rsx-electrical/rsx_standard_library/(commit log)

2025-02-01 add STM32F767ZI symbol
2025-02-01 STM32F767ZI with DPN, MPN and MFR
2025-02-01 Adding Resistor Values: 1.8K, 7.5K, 9.1K, 8.2K
2025-02-01 added 39K resistor
2025-02-01 added 75K resistor
2025-02-08 Added 7.5k resistor
2025-02-08 re-added 10k resistor after it deleted
2025-02-08 added 8.2k resistor
2025-02-08 added 24k resistor
2025-02-08 added 9.1k resistor
2025-02-08 added 1.8k resistor
2025-03-01 update cap, diode, fuse
2025-03-01 added sensors
2025-03-01 75 OHM RESISTOR
2025-03-01 Added Temperature Sensor
2025-03-02 added bms adaptor
2025-03-08 bms additions
2025-03-09 BMS change?
2025-03-15 added footprint
2025-03-22 footprint hall effect
2025-03-22 hall sensor footprint
2025-03-22 buzzer footprint
2025-03-22 button footprint
2025-03-22 button symbol
2025-03-23 add 1k5 resistor
2025-04-26 science board additions
2025-06-21 added new wurth connector (64901229522), schematic + footprint
2025-07-15 added 5V relay
2025-08-14 added all the symbol/footprints/3dModels for the sensor board
2025-08-17 more resistor
2025-10-02 add Jason's current sensor and voltage regulators
2025-10-04 add 0.47 resistor
2025-10-04 add SS2040 diode
2025-10-13 add 12V_iso_reg_TBA21222, wago connector, 4x1 screw terminal, m6 mountinghole
2025-10-15 91K, 82K, PDB MOSFETS, 10K added
2025-10-15 30A diode
2025-10-18 MCH3478 SOT-23 N-Channel 30V/2A
    Transistor
2025-10-18 Arduino Nano Every
2025-10-18 15V power supply added
2025-10-18 addbattery connector
2025-10-18 add push button
2025-10-20 Added Battery Display Components
    Added Components:
    FPC Connector
    Capacitors
    Diodes
    NMOS
2025-10-24 add 15V Voltage reg for PDP
2025-10-25 new 15V voltage reg and transistor datasheet
2025-11-01 Add Wago_2716-101 and Wurth_64900429522 connectors
2025-11-06 fix 3 pos screw terminal for PDP
2025-11-30 add 2pin wurth connector for pdp
2025-12-05 add wurth 64900221122 connector
2026-01-17 added 300k resistor, 100nC capacitor, OPA992IDBVR opamp
2026-01-17 reduced the solder mask expansion of connector pins
2026-01-24 Fixed link between symbol and footprint of OPA2186DR op amp
2026-03-14 add bms controoler
2026-03-17 added footprints for 2pin JST and an UV LED
2026-03-17 Added footprints and symbols for Blue LED and 3pin JST connector
2026-03-17 added updated 2 pin JST connector symbol and footprint
2026-03-17 final updated version of 2 and 3 pin JST connectors footprints and symbols
2026-03-17 moved the UV LED to LED folder from diodes folder
2026-03-17 Added footprint for science CAN capacitor, modified science blue LED pin properties, and reverted changes to the BSS308 diode
2026-03-19 Added capcitor (RDE5C2A220J0M1H03A) symbol to symbols folder (footprint is already there)
2026-03-22 new components for sensor board
2026-03-28 add 47u electrolytic cap5V buck
2026-03-28 resistor reset
2026-03-28 Added 5V buck components (Anthony's board)
2026-05-01 added the 7pin through hole connector symbol and footprint and changed the symbol name for the TJA1050 component
2026-05-05 3.5pitch 2 pin screw terminal
2026-05-08 Making further changes to some Science LEDs and connectors
2026-05-08 Added new capacitor symbol and properties (RDE5C2A220J0M1H03A).
2026-05-21 Added numerous capacitors, resistors and transistors
2026-06-02 added new capacitors
    2.2u
    27p
    33p
    390p
2026-08-13 Added PBQ41Z90PVPT BMS chip used for sensing, fuel guaging and protection
2026-08-13 Added Components for BMS cell balancing external circuit
    Additions:
    18R_2W
    22R
    50R
    T2N7002BK,LM
2026-08-19 Added resistors and new nmos
    40.2R
    56R
    AO3414
2026-08-22 Added shunt resistor and thermistor for BMS
2026-10-11 Added IC DIP Socket 2x4
    - used in programmer board (ATTiny)
    - misc
    - https://www.digikey.ca/en/products/detail/te-connectivity-amp-connectors/1-2199298-2/5022039
2026-10-12 Added IC DIP Socket 2x19 + Fixes
    - used in programmer board (ATMega)
    - Added IC DIP Socket 2x4 information
    - https://www.digikey.ca/en/products/detail/on-shore-technology-inc/ED281DT/4147600
    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
2026-10-17 Added 2.54MM F Header 1x8
2026-10-17 Added Socket Header 1x4, 1x6, 1x8 for Arduino
2026-10-17 5v reg
2026-10-31 15W shunt resistor
2026-11-07 For Battery Display onboarding project
